DrMarkusReinhardt/MySimple4ChannelDAS/SW/PC/README.md

# Evaluate4ChannelMeasurements

Evaluate four channel measurements received from an Arduino board in a Python application.

Usage:
  ./Eval4ChannelVoltageMeasurements

This shell script calls the python interpreter that executes the Python
four channel measurement program.
