DrMarkusReinhardt/MySimple4ChannelDAS/DOC/MySimple4ChannelDAS.tex

\documentclass[11pt, oneside]{scrartcl}   	% use "amsart" instead of "article" for AMSLaTeX format

%%%%%%%%%%%%%%%%%%%%%%%%%%%%%%%%%%%%%%%%%%%%%%%%%%%%%%%%%%%%%%%%%%%%%%%
% packages
\usepackage[portrait]{geometry}               		% See geometry.pdf to learn the layout options. There are lots.
\geometry{a4paper}                   		% ... or a4paper or a5paper or ...
%\geometry{landscape}                		% Activate for rotated page geometry
%\usepackage[parfill]{parskip}    		% Activate to begin paragraphs with an empty line rather than an indent
\usepackage{graphicx}				% Use pdf, png, jpg, or eps with pdflatex; use eps in DVI mode
							% TeX will automatically convert eps --> pdf in pdflatex
\usepackage{amssymb}
\usepackage{amsmath}
\usepackage{tikz}
\usepackage{tikz-3dplot}
\usepackage{mathtools}
\usepackage{pgfplots}
\usetikzlibrary{angles, quotes}
\pgfplotsset{width=7cm,compat=newest}
\usepackage{listings}
\usepackage[d]{esvect}
\usepackage{color}
\usepackage{eso-pic}
\usepackage{hyperref}

% \include{mydefines}

%%%%%%%%%%%%%%%%%%%%%%%%%%%%%%%%%%%%%%%%%%%%%%%%%%%%%%%%%%%%%%%%%%%%%%%
% color definitions
\definecolor{mygreen}{rgb}{0,0.6,0}
\definecolor{mygray}{rgb}{0.5,0.5,0.5}
\definecolor{mymauve}{rgb}{0.58,0,0.82}

%%%%%%%%%%%%%%%%%%%%%%%%%%%%%%%%%%%%%%%%%%%%%%%%%%%%%%%%%%%%%%%%%%%%%%%
% definitions for listings
\lstset{ 
	backgroundcolor=\color{white},   % choose the background color; you must add \usepackage{color} or \usepackage{xcolor}; should come as last argument
	basicstyle=\footnotesize,        % the size of the fonts that are used for the code
	breakatwhitespace=false,         % sets if automatic breaks should only happen at whitespace
	breaklines=true,                 % sets automatic line breaking
	captionpos=b,                    % sets the caption-position to bottom
	commentstyle=\color{mygreen},    % comment style
	deletekeywords={...},            % if you want to delete keywords from the given language
	escapeinside={\%*}{*)},          % if you want to add LaTeX within your code
	extendedchars=true,              % lets you use non-ASCII characters; for 8-bits encodings only, does not work with UTF-8
	firstnumber=1000,                % start line enumeration with line 1000
	frame=single,	                   % adds a frame around the code
	keepspaces=true,                 % keeps spaces in text, useful for keeping indentation of code (possibly needs columns=flexible)
	keywordstyle=\color{blue},       % keyword style
	language=Octave,                 % the language of the code
	morekeywords={*,...},            % if you want to add more keywords to the set
	numbers=left,                    % where to put the line-numbers; possible values are (none, left, right)
	numbersep=5pt,                   % how far the line-numbers are from the code
	numberstyle=\tiny\color{mygray}, % the style that is used for the line-numbers
	rulecolor=\color{black},         % if not set, the frame-color may be changed on line-breaks within not-black text (e.g. comments (green here))
	showspaces=false,                % show spaces everywhere adding particular underscores; it overrides 'showstringspaces'
	showstringspaces=false,          % underline spaces within strings only
	showtabs=false,                  % show tabs within strings adding particular underscores
	stepnumber=2,                    % the step between two line-numbers. If it's 1, each line will be numbered
	stringstyle=\color{mymauve},     % string literal style
	tabsize=2,	                   % sets default tabsize to 2 spaces
	title=\lstname                   % show the filename of files included with \lstinputlisting; also try caption instead of title
}

%%%%%%%%%%%%%%%%%%%%%%%%%%%%%%%%%%%%%%%%%%%%%%%%%%%%%%%%%%%%%%%%%%%%%%%
% headlines and footlines
\usepackage[headsepline]{scrlayer-scrpage}
\pagestyle{scrheadings}
\clearpairofpagestyles
% \ohead{\textsf{Section \thesection}}  % \thesection
\ohead{\headmark}
\automark[subsection]{section}

% \chead{\textsf{Page \thepage}}
\chead[\pagemark]{Page \pagemark}
\ihead{\textsf{Project Description}}
\cfoot[\pagemark]{Page \pagemark}
%%%%%%%%%%%%%%%%%%%%%%%%%%%%%%%%%%%%%%%%%%%%%%%%%%%%%%%%%%%%%%%%%%%%%%%

\setlength{\parindent}{0pt}

%%%%%%%%%%%%%%%%%%%%%%%%%%%%%%%%%%%%%%%%%%%%%%%%%%%%%%%%%%%%%%%%%%%%%%%
% new commands
\newcommand{\mb}[1]{{\mathbf #1}}

\begin{document}

%%%%%%%%%%%%%%%%%%%%%%%%%%%%%%%%%%%%%%%%%%%%%%%%%%%%%%%%%%%%%%%
% title page
\begingroup
	\thispagestyle{empty}
	\centering
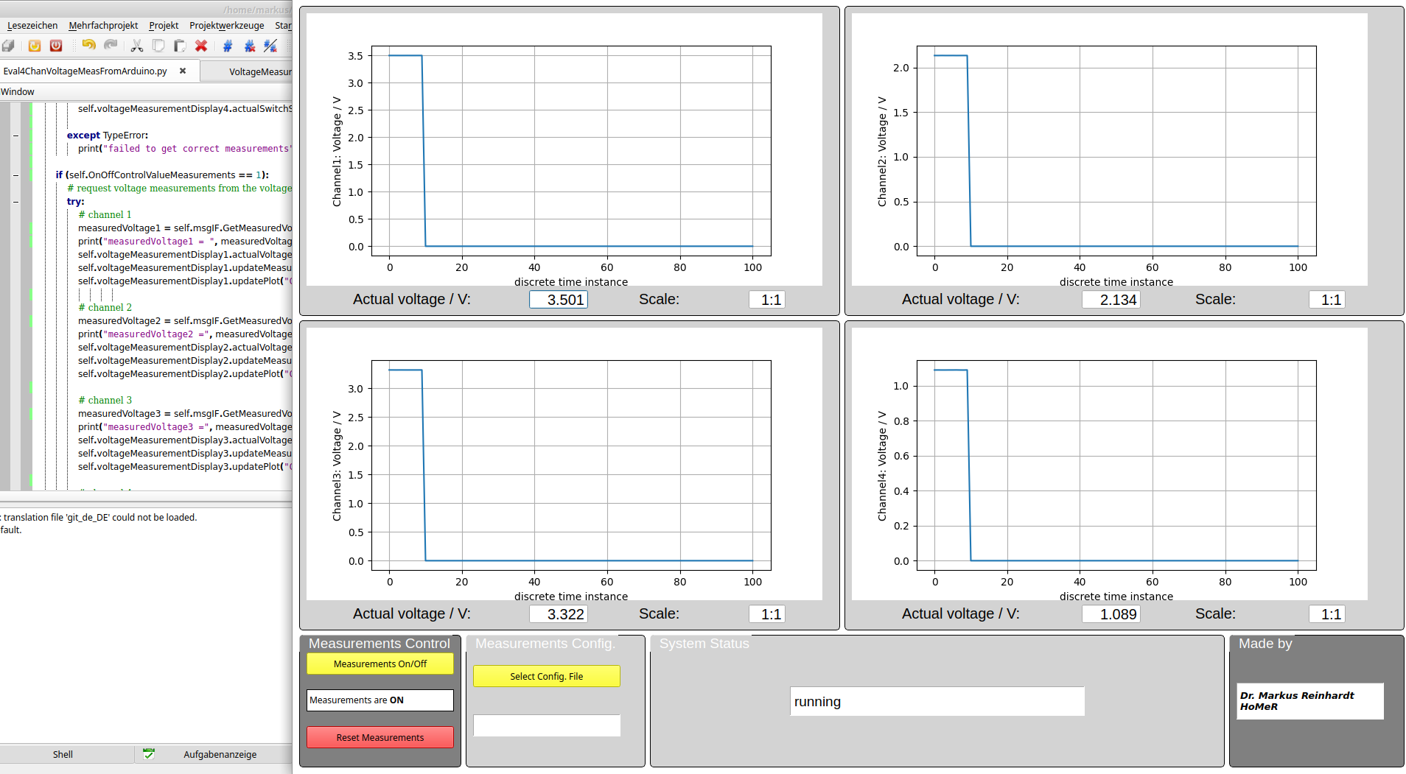
[picture p2: DOC/Figures/ApplicationWindow.png]
	\AddToShipoutPicture*{\put(30,100){}} % Image background
	\par\normalfont\fontsize{30}{30}\sffamily\selectfont
	\vspace*{1.0cm}
	{\color{blue}
		\textbf{\Huge My Simple 4-Channel DAS} \\ 
		\textbf{\huge Description and Evaluation} \\
		\vspace*{0.5cm}
		\hspace{-0.3cm}
		{\textbf\huge by Dr. Markus Reinhardt }\par % Book title
		\hspace{-1.3cm}
		{\textbf \huge  \today}\par % Author name
		\vspace*{1.5cm}
	}
\endgroup
\vfill

%%%%%%%%%%%%%%%%%%%%%%%%%%%%%%%%%%%%%%%%%%%%%%%%%%%%%%%%%%%%%%%
% table of contents
\newpage
\thispagestyle{empty}
\tableofcontents
\newpage

%%%%%%%%%%%%%%%%%%%%%%%%%%%%%%%%%%%%%%%%%%%%%%%%%%%%%%%%%%%%%%%
% lists of figures and tables
\newpage
\thispagestyle{empty}
\listoffigures
\listoftables

%%%%%%%%%%%%%%%%%%%%%%%%%%%%%%%%%%%%%%%%%%%%%%%%%%%%%%%%%%%%%%%
% the main text
\newpage
\pagestyle{scrheadings}
\section{Concept description}
A simple 4-channel low sample rate, high accuracy (16-bit ADC)
Arduino based Data Acquisition System (DAS) to support general PC controlled universal 
measurement campaigns has been built.\\

The signals to be measured are fed to a 1:10 divider or via a 1:1 connection to the buffer amplifier of each channel.
The signals are then ADC converted by the 4 channel ADS1115 ADC on the ADC module.
The Arduino Uno is controlling the ADS1115 and receiving the digitized signals via the I2C interface.
The data is then sent to the PC via the SoftwareSerial port, a USB/Serial module using the CmdMessenger library to the PC.
On the PC a Python (PyQt) or C++ (Qt) program using also the (Py)CmdMessenger library is receiving, evaluating and displaying the data.

The projects consists of the following main HW components:
\begin{itemize}
	\item An Arduino Uno to control the measurements and to report the measurements to the PC.
	\item An USB/Serial module to connect the PC with the Uno via the SoftwareSerial interface and an USB connector.
	\item A 4-Channel ADS1115 16-bit ADC module.
	\item A 4-Channel 1x buffer amplifier board, LM324 based.
	\item 4-Channel signal paths with 1:10 or 1:1 signal scaling selected by switches and related resistor dividers. 
	\item A cheap plastic case.
\end{itemize}

The projects consists of the following main SW components:
\begin{itemize}
	\item An Arduino sketch to control the ADC module and to send the data and the scaling switch states via the serial interface to the PC.
	\item A C++ / Qt based software library to sample, store and evaluate data from up to 4 channels.
	\item A PyQt based Python program running on the PC to receive and store the data from up to 4 channels and to scale the received signals according to the selected and reported scaling states.
\end{itemize}

\newpage
\section{Schematics} 
The schematics are shown in figure \ref{fig:Schematics}.
\begin{figure}[htbp]
	\centering
	
	\caption[Schematics]{Schematics}
	\label{fig:Schematics}
\end{figure}
The input section for each channel consists of the connectors for the 1:1 and the 1:10 scaling path. In the 1:10 path a resistor divider divides the input signal
by 10 and feeds the attenuated signal to the switch that selects the input path. After the switch the signal is fed to the buffer amplifier with has a gain factor of 1.0 and from there to one of the four channels of the ADC module.
Each switch is a DPDT type switch. One path is used for switching of the scaling path, the other for the reporting of the switch state to the micro-controller. 
The ADC module is controlled from an Arduino Uno that provides also the interface to the PC via a USB/Serial module.

\section{Hardware setup}
The four channel DAS front view of the case with the sockets and the switches four each of the four channels is shown in figure \ref{fig:HWExternals}.
\begin{figure}[htbp]
	\centering
	
	\caption{Four channel DAS front view of case)}
	\label{fig:HWExternals}
\end{figure}
The upper row of the sockets are the inputs of the paths with 1:10 scaling of the signals, the middle row of sockets are the inputs of the paths with 1:1 scaling of the signals.
The lower row of the sockets are the ground connections.

The internal HW is shown in figure \ref{fig:HWInternals}.
\begin{figure}[htbp]
	\centering
	
	\caption{HW inside the case}
	\label{fig:HWInternals}
\end{figure}
It shows the Arduino Uno board, the ADC board, the USB/Serial converter module, the buffer amplifier (LM324) all mounted on a bread board.
There are twelve 4mm connectors assembled on the front panel, four for ground connections, four for buffered signals and four for (by a factor of 1:10) 
attenuated and also buffered signals.

The used ADC module is shown in figure \ref{fig:ADCModule}.
\begin{figure}[htbp]
	\centering
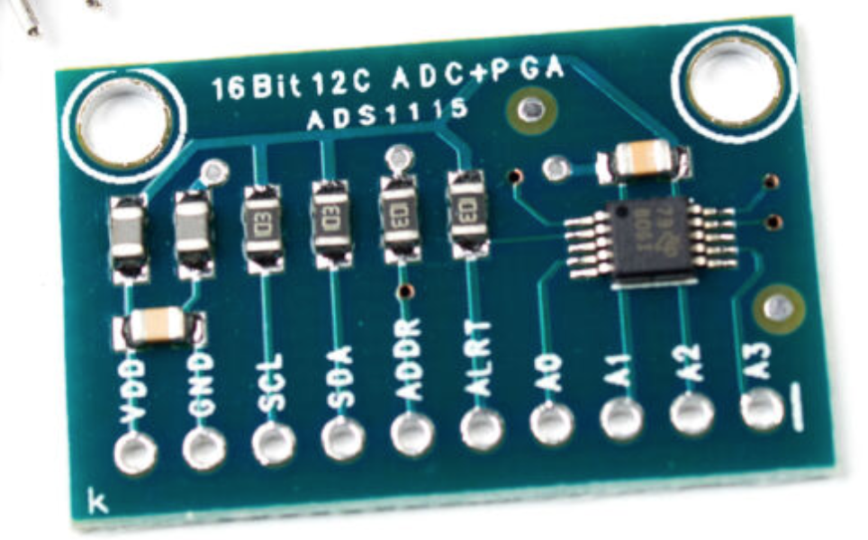
[picture p4: DOC/Figures/ADS1115ADCBoard.png]
	
	\caption{ADC module with ADS1115}
	\label{fig:ADCModule}
\end{figure}

\newpage
\section{Software}
\subsection{Arduino Sketch}
The Arduino sketch is running on an Arduino Uno. It consists of 3 tasks.

The first task is the blinker task that blinks the on-board LED, i.~e. it is working as an alive-signal.

The second task is the communication task that receives request/commands from the PC via the CmdMessenger Library and sends on request the voltage measurements
back to the PC program. The CmdMessenger interface uses the SoftwareSerial library for the communication via a USB/Serial module to the PC. 
Arduino digital pins 2 (RX) and 3 (TX) are used by the SoftwareSerial library.

The third task is the measurement task that handles the I2C interface to the ADC module to get the measurement values. The standard I2C pins of the Arduino Uno are used here, i.~e. Pins A4/SDA and A5/SCL). Pin A0 is used for the ADC module's ALERT pin interfacing.

The measured voltages and the status of the scale switches are also printed to the standard Arduino Serial port (/dev/ttyACM0) and can be watched with the Arduino Serial Monitor of the IDE.
The trace of the measured voltages in the Arduino IDE Serial Monitor after the program setup is done is shown in figure \ref{fig:ArduinoSerialMonitorTrace}.
\begin{figure}[htbp]
	\centering
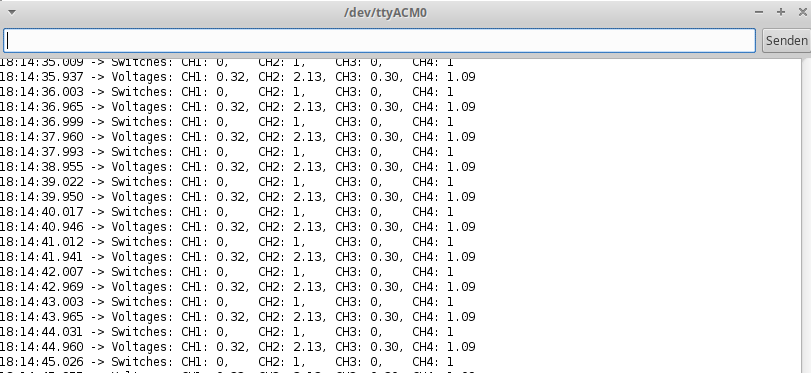
[picture p5: DOC/Figures/ArduinoSerialMonitorTrace.png]
	
	\caption[Arduino Serial Monitor: Trace of four measured voltages and scale switches]{Arduino Serial Monitor: Trace of the four measured voltages and scale switches}
	\label{fig:ArduinoSerialMonitorTrace}
\end{figure}

\subsection{PC Application}
The GUI of the Python PC application together with the Eric6 IDE is shown in figure \ref{fig:ApplicationWindow} after around 10 voltage samples have been processed for all four channels.
The program is called by the shell script Eval4ChannelVoltageMeasurements which calls the python interpreter to execute the python program Eval4ChanVoltageMeasFromArduino.py.\\

The program reads via the PyCmdMessenger library the four measured voltages and the status of the scaling switches from the Arduino board
via the USB/Serial module on port /dev/ttyUSB0 and displays the voltages vs. the discrete sample time index in four separate plots.
The scaling of the ordinate of the plots is done automatically with the reception of each new sample. 
In addition the actual measured voltage values and the voltage scaling values (1:1 or 1:10) chosen by the switches for all channels are displayed below the plots.

The program also allows to store the measured data and to control the measurements via start/stop/reset commands in the GUI.
\begin{figure}[htbp]
	\centering
	
	\caption[Python PC Application]{Python PC Application}
	\label{fig:ApplicationWindow}
\end{figure}

The program allows to (re-)start, stop and reset the measurements.

The GUI of the PC program when the scaling of 1:10 is selected for the channels 1 and 3 and the scaling of 1:1 is selected for channels 2 and 4 is shown in figure \ref{fig:ApplicationWindow1}.
\begin{figure}[htbp]
	\centering
	
	\caption[Python PC Application]{Python PC Application}
	\label{fig:ApplicationWindow1}
\end{figure}

\end{document}
