DrMarkusReinhardt/MySimple4ChannelDAS/DOC/Figures/HWInternals1.pdf

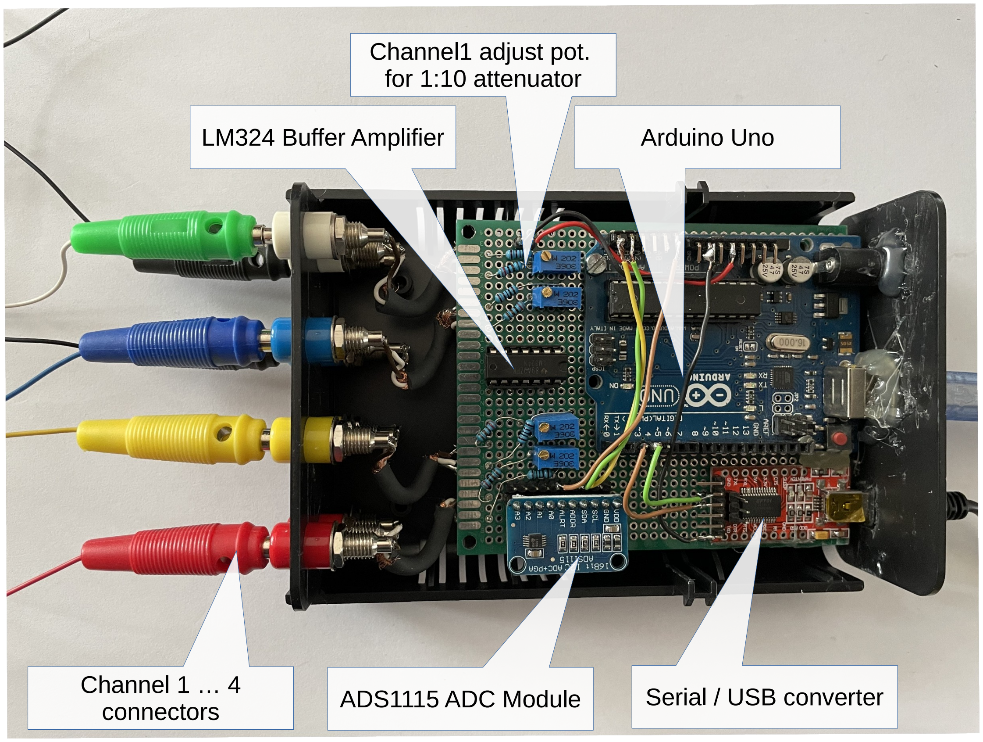
[picture p6: page 1]

ADS1115 ADC Module

LM324 Buffer Amplifier | Arduino Uno

Serial / USB converter

Channel1 adjust pot.
for 1:10 attenuator

Channel 1 … 4
connectors
