DrMarkusReinhardt/MySimple4ChannelDAS/DOC/Figures/ADS1115Module.png

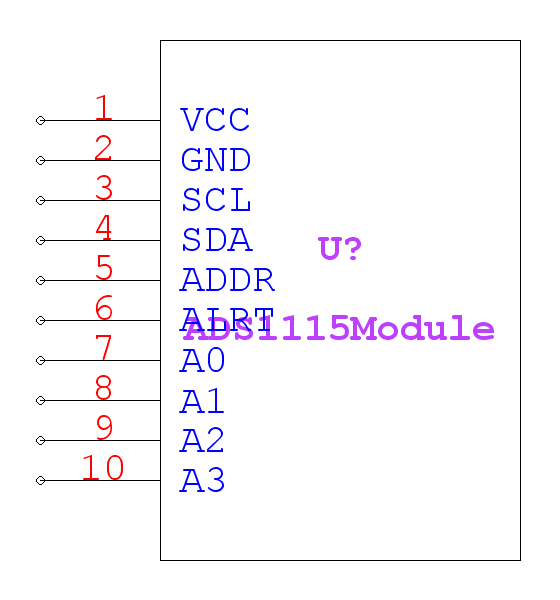
DOC/Figures/ADS1115Module.png
