DrMarkusReinhardt/MySimple4ChannelDAS/DOC/Figures/NodeMCU-ESP8266-PINs-pinout.jpg

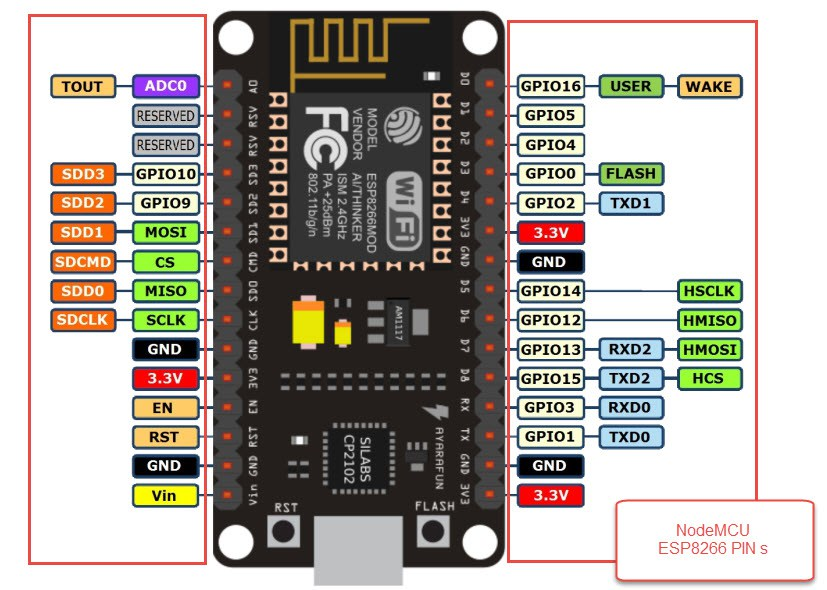
DOC/Figures/NodeMCU-ESP8266-PINs-pinout.jpg
