DrMarkusReinhardt/MySimple4ChannelDAS/Schematics/MySimple4ChannelDAS.sch

## KiCad design Schematics/MySimple4ChannelDAS.sch (2021-07-16)

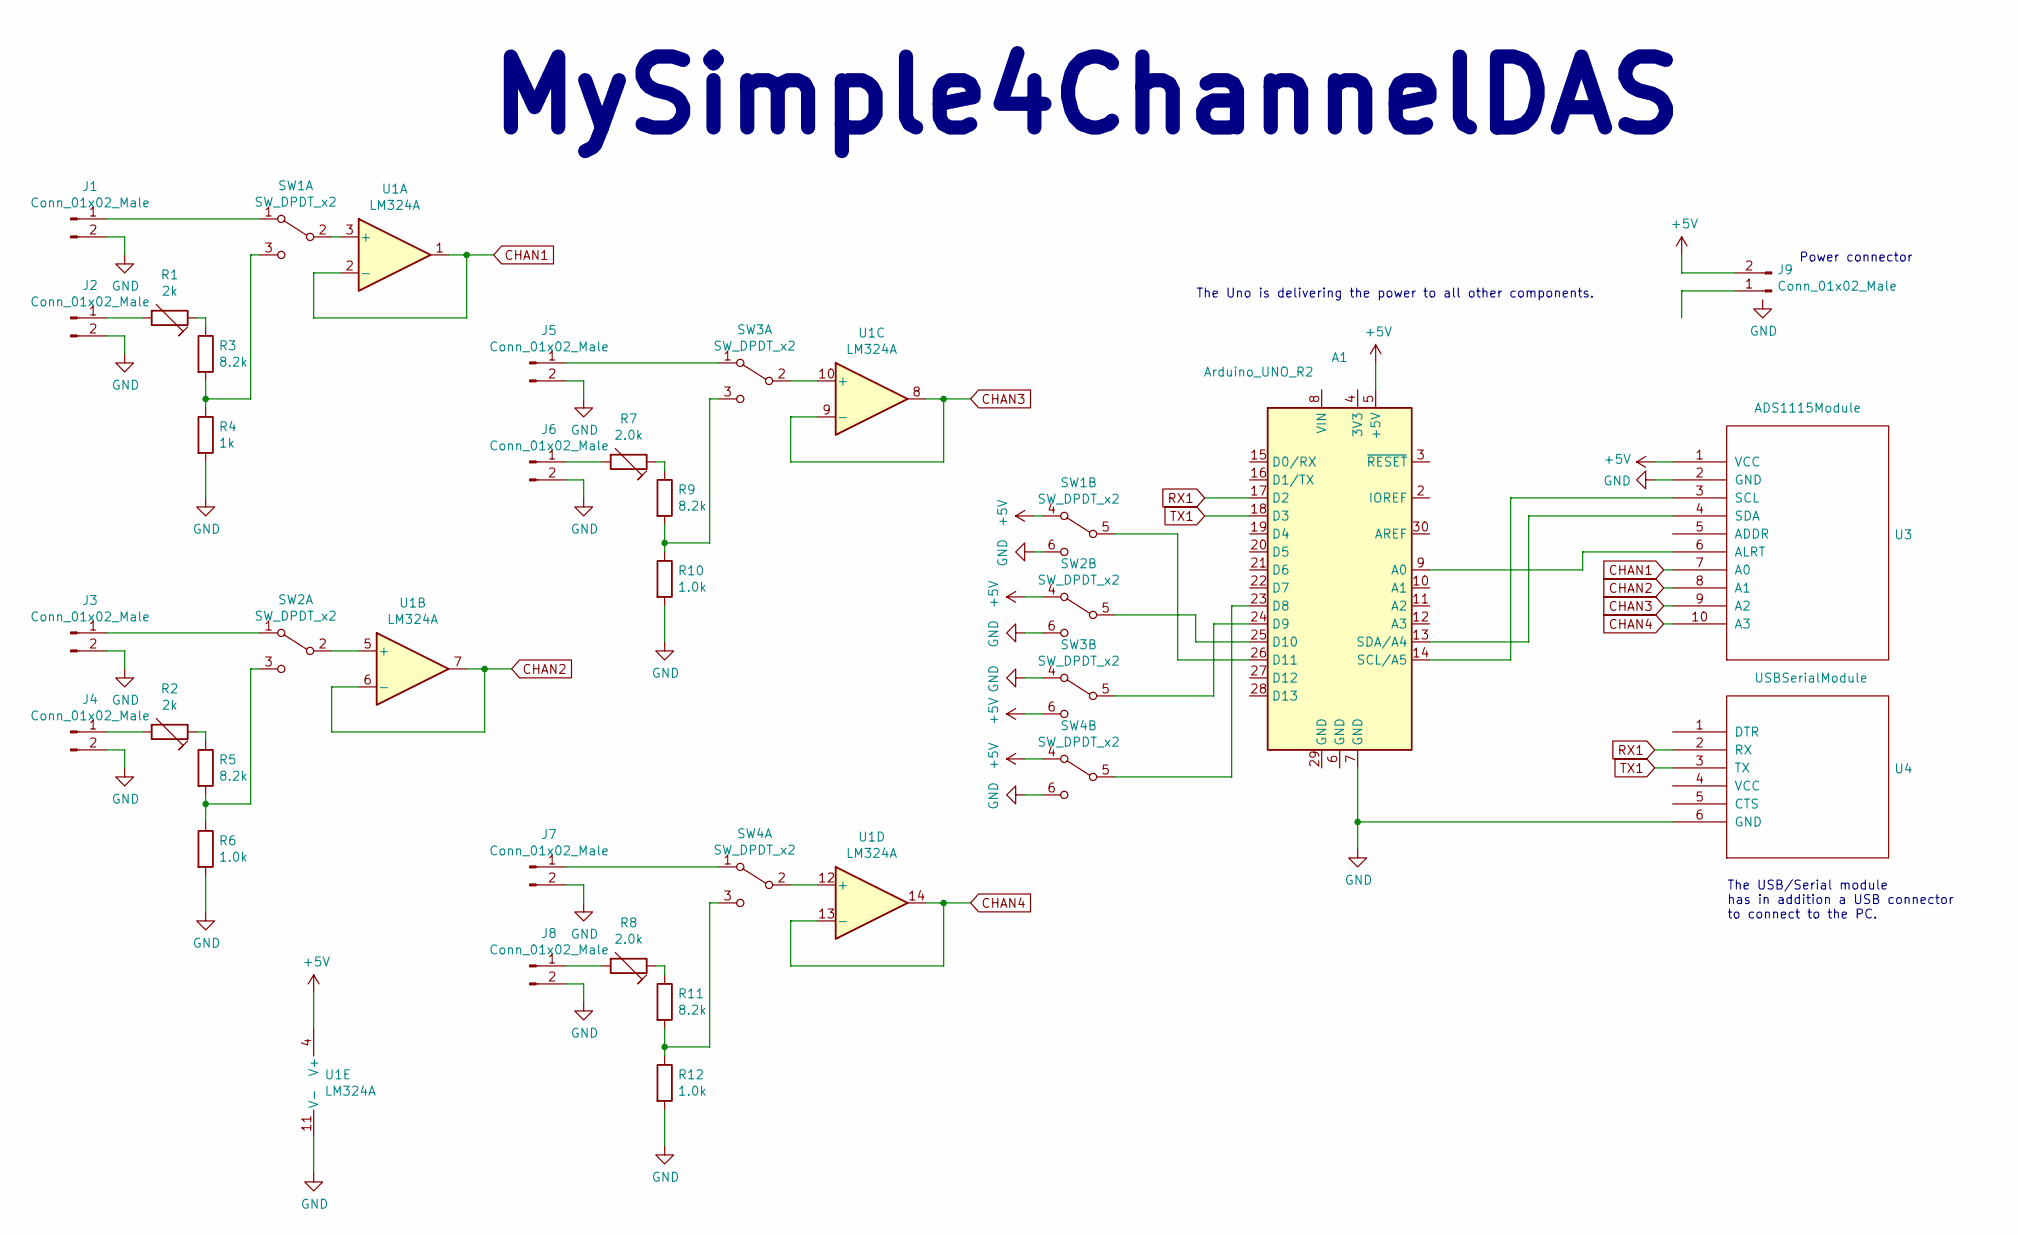
[picture p12: schematic MySimple4ChannelDAS.sch]

Parts:
A1: Arduino_UNO_R2
J1, J2, J3, J4, J5, J6, J7, J8, J9: Conn_01x02_Male
R1, R2: 2k
R3, R5, R9, R11: 8.2k
R4: 1k
R6, R10, R12: 1.0k
R7, R8: 2.0k
SW1, SW2, SW3, SW4: SW_DPDT_x2
U1: LM324A
U3: ADS1115Module; MODULE
U4: USBSerialModule; MODULE

Connections:
+5V: A1.5 (+5V), J9.2, SW1.4 (A), SW2.4 (A), SW3.6 (C), SW4.4 (A), U1.4 (V+), U3.1 (VCC)
CHAN1: U1.1, U1.2 (-), U3.7 (A0)
CHAN2: U1.6 (-), U1.7, U3.8 (A1)
CHAN3: U1.8, U1.9 (-), U3.9 (A2)
CHAN4: U1.13 (-), U1.14, U3.10 (A3)
GND: A1.7 (GND), J1.2, J2.2, J3.2, J4.2, J5.2, J6.2, J7.2, J8.2, R4.2, R6.2, R10.2, R12.2, SW1.6 (C), SW2.6 (C), SW3.4 (A), SW4.6 (C), U1.11 (V-), U3.2 (GND), U4.6 (GND)
unnamed: A1.9 (A0), U3.6 (ALRT)
unnamed: A1.13 (SDA/A4), U3.4 (SDA)
unnamed: A1.14 (SCL/A5), U3.3 (SCL)
unnamed: A1.23 (D8), SW4.5 (B)
unnamed: A1.24 (D9), SW3.5 (B)
unnamed: A1.25 (D10), SW2.5 (B)
unnamed: A1.26 (D11), SW1.5 (B)
unnamed: J1.1, SW1.1 (A)
unnamed: J2.1, R1.2
unnamed: J3.1, SW2.1 (A)
unnamed: J4.1, R2.2
unnamed: J5.1, SW3.1 (A)
unnamed: J6.1, R7.2
unnamed: J7.1, SW4.1 (A)
unnamed: J8.1, R8.2
unnamed: R1.1, R3.1
unnamed: R2.1, R5.1
unnamed: R3.2, R4.1, SW1.3 (C)
unnamed: R5.2, R6.1, SW2.3 (C)
unnamed: R7.1, R9.1
unnamed: R9.2, R10.1, SW3.3 (C)
unnamed: R8.1, R11.1
unnamed: R11.2, R12.1, SW4.3 (C)
unnamed: SW1.2 (B), U1.3 (+)
unnamed: SW2.2 (B), U1.5 (+)
unnamed: SW3.2 (B), U1.10 (+)
unnamed: SW4.2 (B), U1.12 (+)
RX1: A1.17 (D2), U4.2 (RX)
TX1: A1.18 (D3), U4.3 (TX)

Notes on the sheet:
MySimple4ChannelDAS
Power connector
The Uno is delivering the power to all other components.
The USB/Serial module has in addition a USB connector to connect to the PC.
