DrMarkusReinhardt/MySimple4ChannelDAS/SW/Arduino/FourChannelVoltageMeasurements/FourChannelVoltageMeasurements.ino

/* Sketch to measure voltages and communicate the values to the PC via
 * CmdMessenger
 *
 *
 * @author: Dr. Markus Reinhardt
 * @date:   30th March 2021
 *
 */

#include <Arduino.h>
#include <BlinkerTask.h>
#include <SoftwareSerial.h>
#include "CommunicationTask.h"
#include "MeasurementsTask.h"

#define BlinkerPeriod 1000
#define CommsPeriod 1000         // period between the activations of the communication task in milliseconds
#define MeasurementsPeriod 1000  // period between the activations of the measurements task in milliseconds

SoftwareSerial SWSerial(2,3);

BlinkerTask blinker(LED_BUILTIN, BlinkerPeriod);
CommunicationTask comms(CommsPeriod);
MeasurementsTask measurements(MeasurementsPeriod);

// the initial program setup
void setup()
{
  // start the serial port for the CmdMessenger interface
  Serial.begin(9600);

  // start the debug serial port
  SWSerial.begin(9600);
  // SWSerial.println(F("SWSerial setup done"));

  // setup the measurements task
  measurements.setup();

  // setup the communication task
  comms.setup();
}

// the loop to start all tasks and to run the task scheduler (never returns)
void loop()
{
    // Initialise the task list and scheduler.
    // Task *tasks[] = {&blinker, &keyboardHandler, &measurements, &smpsControl};
    Task *tasks[] = {&blinker, &comms, &measurements};
    TaskScheduler sched(tasks, NUM_TASKS(tasks));

    // Run the scheduler - never returns.
    sched.run();
}
