DrMarkusReinhardt/MySimple4ChannelDAS/(commit log)

2021-05-19 added doc and schematics
    [MySimple4ChannelDAS.sch]
2021-05-21 added a first Arduino program (untested)
2021-05-29 updated eval LiPo charge Python program
2021-06-04 updated eval LiPo charging
2021-06-04 updated schematics and doc
    [MySimple4ChannelDAS.sch]
2021-06-05 updated Arduino and PC program
2021-07-09 updated schematics
    [MySimple4ChannelDAS.sch]
2021-07-16 added processing of switches
    [MySimple4ChannelDAS.sch]
2021-07-16 added the ADC data sheet
