DrMarkusReinhardt/MySimple4ChannelDAS/DOC/Figures/HWExternals.jpeg

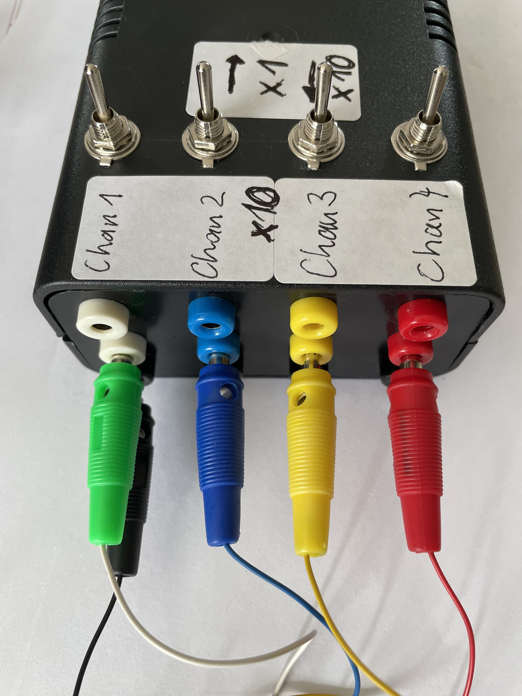
[picture p3: DOC/Figures/HWExternals.jpeg]
DOC/Figures/HWExternals.jpeg
