DrMarkusReinhardt/MySimple4ChannelDAS/DOC/Figures/HWInternals.jpeg

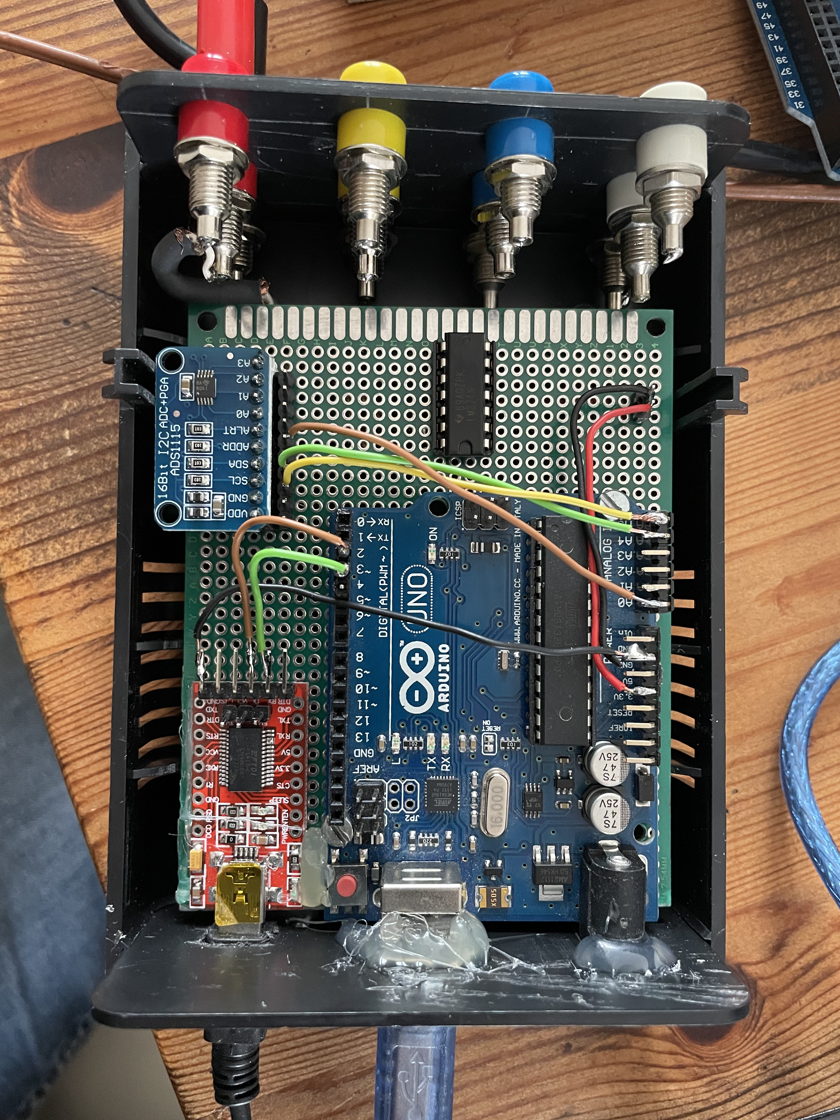
DOC/Figures/HWInternals.jpeg
