DrMarkusReinhardt/MySimple4ChannelDAS/DOC/Figures/HWInternals1.jpeg

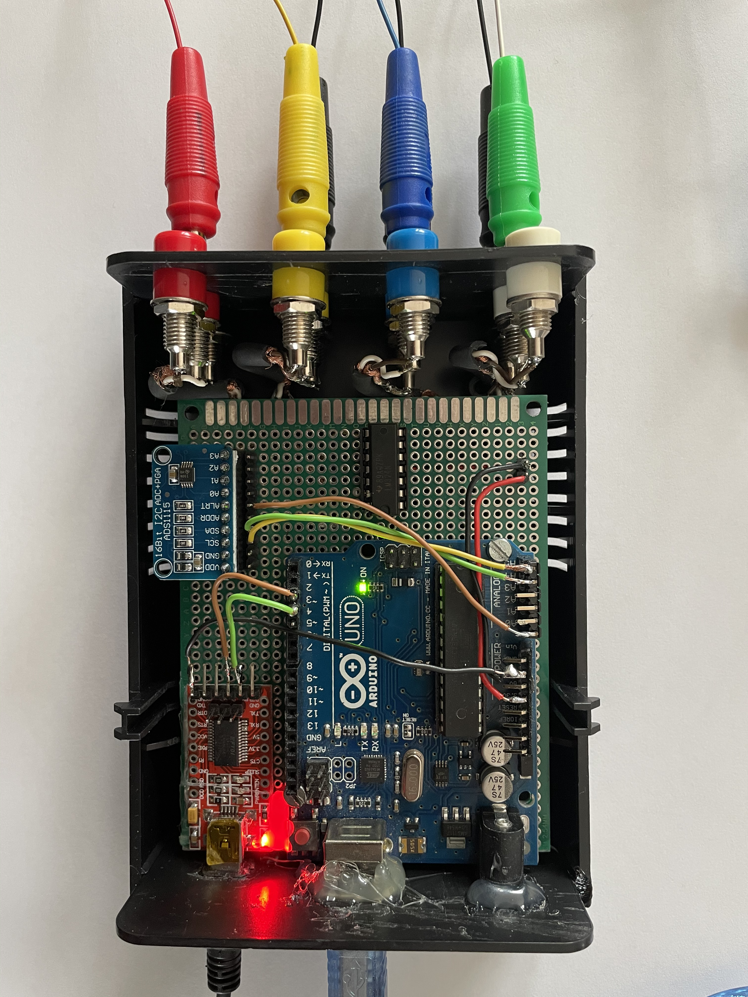
DOC/Figures/HWInternals1.jpeg
