DrMarkusReinhardt/MySimple4ChannelDAS/DOC/Figures/HWInternals2.jpeg

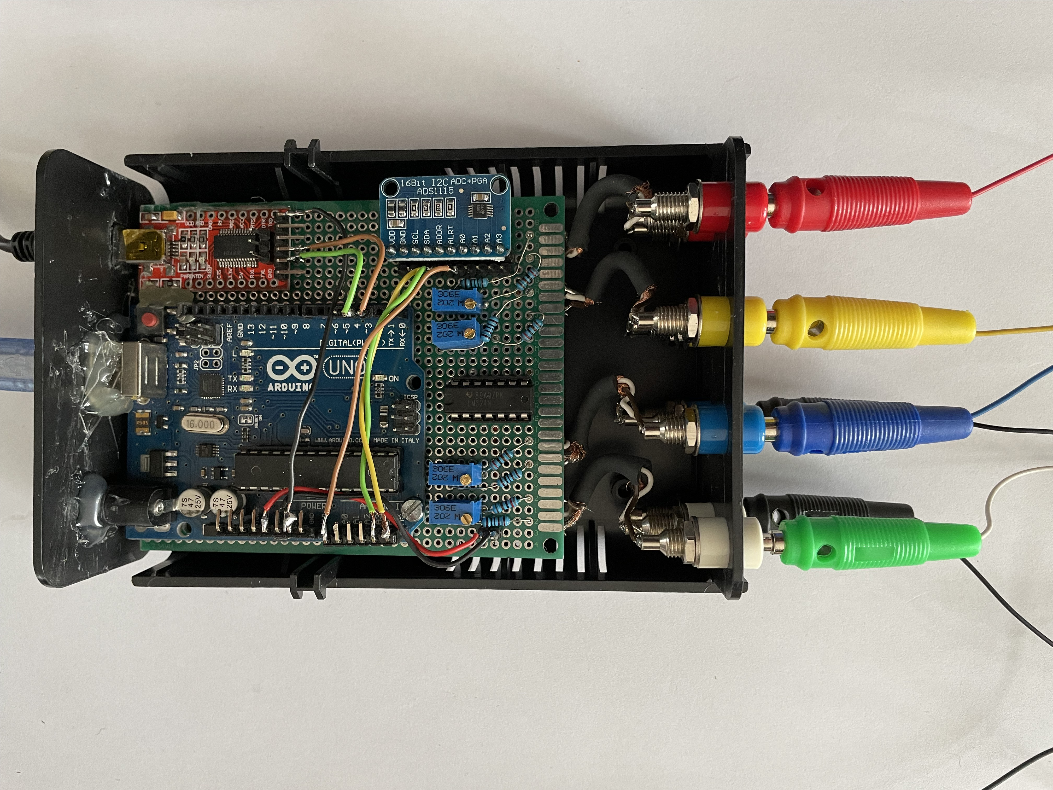
DOC/Figures/HWInternals2.jpeg
